HA2ZB/APRS_TNC/Hardware/HA2ZB APRS TNC prototype hardware setup.pdf

### HA2ZB APRS TNC prototype hardware setup

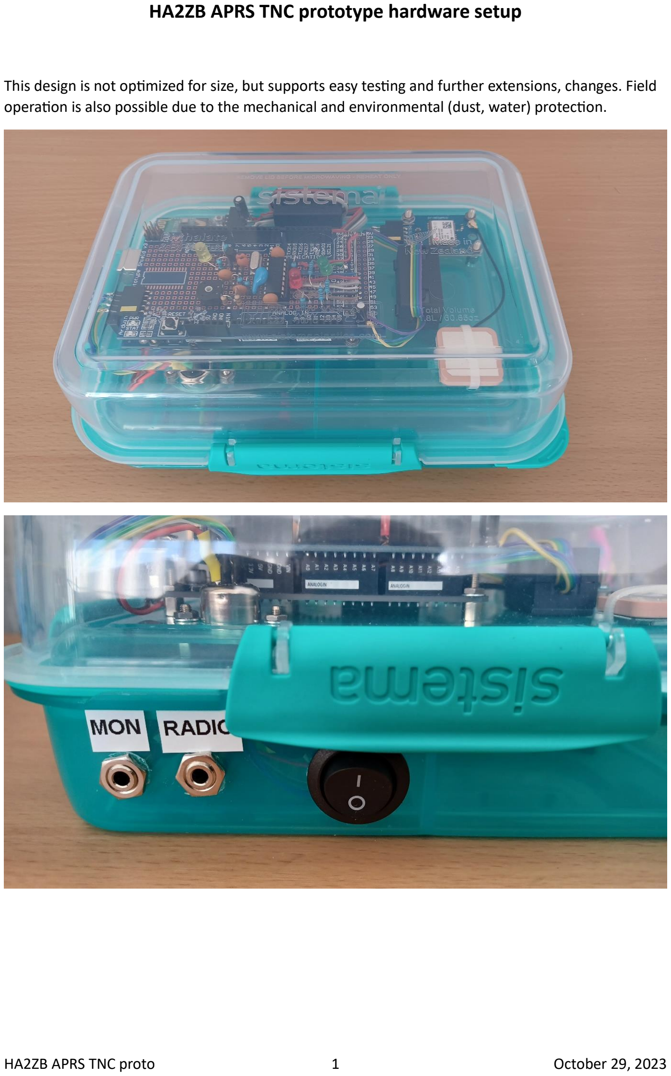
[picture p1: page 1]

HA2ZB APRS TNC proto | 1 | October 29, 2023

This design is not optimized for size, but supports easy testing and further extensions, changes. Field operation is also possible due to the mechanical and environmental (dust, water) protection.

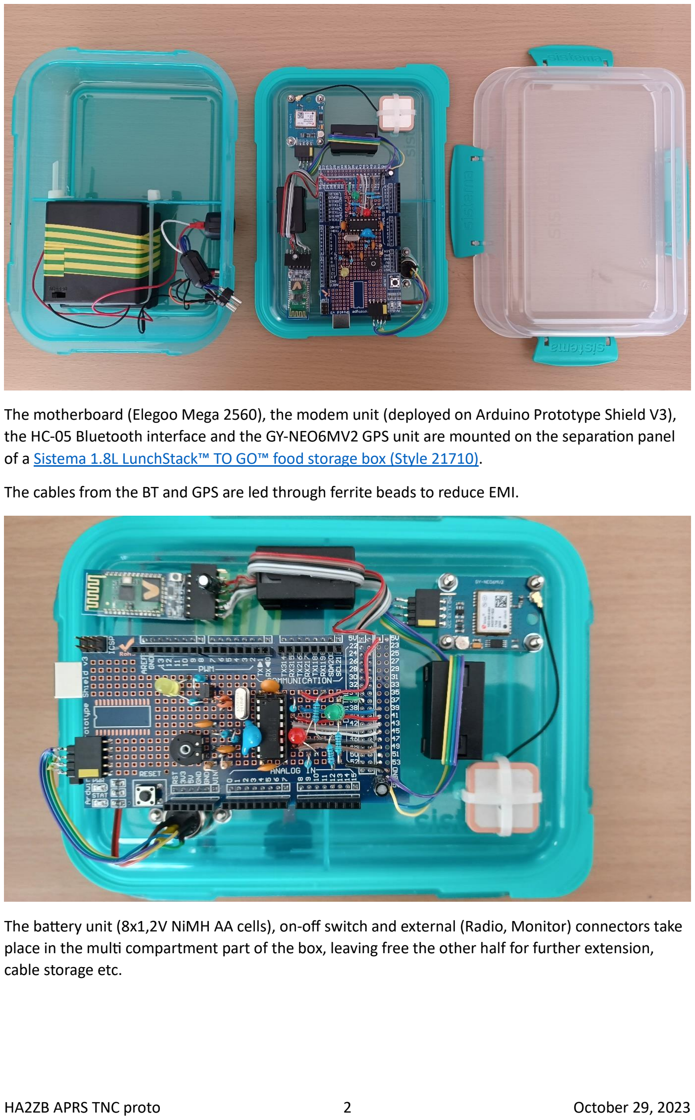
[picture p2: page 2]

HA2ZB APRS TNC proto | 2 | October 29, 2023

The motherboard (Elegoo Mega 2560), the modem unit (deployed on Arduino Prototype Shield V3), the HC-05 Bluetooth interface and the GY-NEO6MV2 GPS unit are mounted on the separation panel of a Sistema 1.8L LunchStack™ TO GO™ food storage box (Style 21710). (https://www.sistemaplastics.com/1-8l-lunchstack-to-go-rectangle)

The cables from the BT and GPS are led through ferrite beads to reduce EMI.

The battery unit (8x1,2V NiMH AA cells), on-off switch and external (Radio, Monitor) connectors take place in the multi compartment part of the box, leaving free the other half for further extension, cable storage etc.

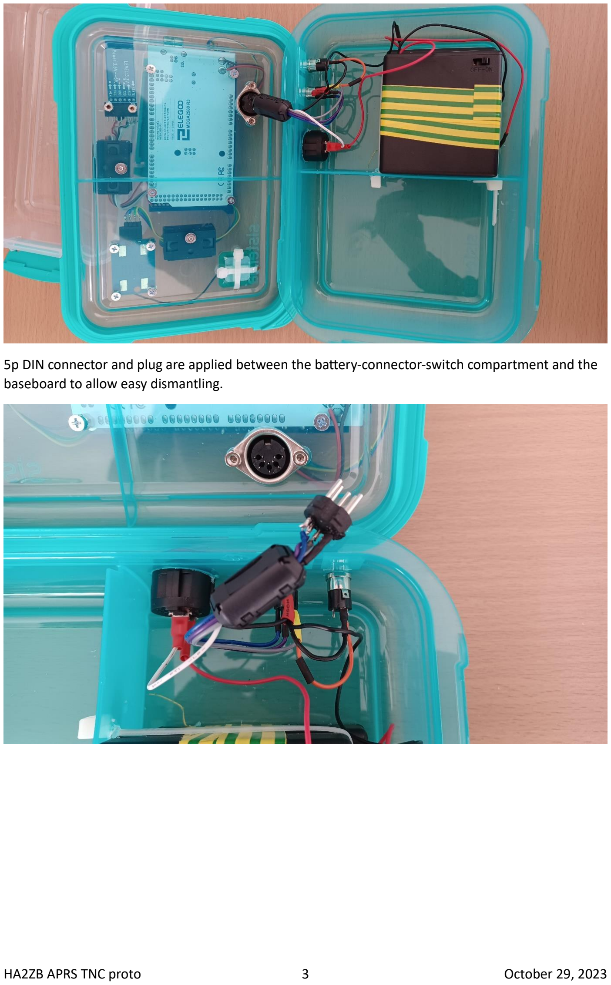
[picture p3: page 3]

HA2ZB APRS TNC proto | 3 | October 29, 2023

5p DIN connector and plug are applied between the battery-connector-switch compartment and the baseboard to allow easy dismantling.
