HA2ZB/APRS_TNC/(commit log)

2023-07-29 Modem to KISS, not working
    [APRS_TNC.ino, HDLC_MX614.cpp, HDLC_MX614.h]
2023-08-12 First working version
    This code was shortly tested on a breadboard prototype with Wouxun handheld radio.
    [APRS_TNC.ino, HDLC_MX614.cpp, HDLC_MX614.h, KISS_communication.cpp]
2023-08-27 Working TNC with APRSDroid
    [APRS_TNC_HA2ZB_modem.sch, ~APRS_TNC_HA2ZB_modem.sch]
2023-08-28 Modem SCH completed
    [APRS_TNC_HA2ZB_modem.sch, ~APRS_TNC_HA2ZB_modem.sch]
2023-09-09 First public code
    This is the first publicly released code for the Arduino based APRS TNC
2023-10-26 HW proto related updates
    HDLC_MX614 port renumbering
    APRS library started - do not use!
    Modem schematic updates
    Read.me updates
    [APRS_TNC_HA2ZB_modem.sch, ~APRS_TNC_HA2ZB_modem.sch]
2023-10-29 TNC HW description, BT STATE
    TNC HW description pdf added, BT STATE signal connected to D36
    [APRS_TNC_HA2ZB_modem.sch]
